dessaya/cese-tpfinal/Figures/disp-captura-cerrado.jpg

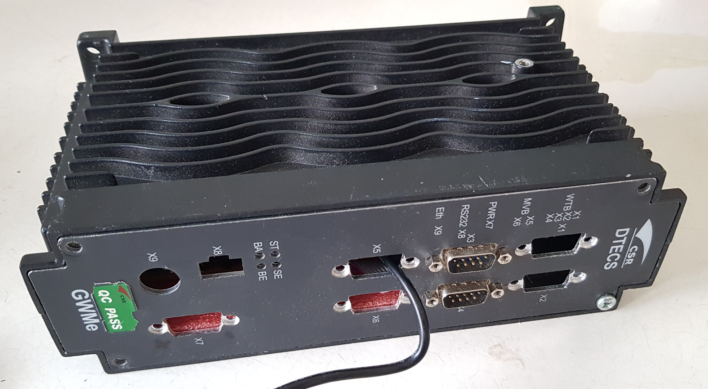
Figures/disp-captura-cerrado.jpg
