dessaya/cese-tpfinal/Figures/foto-dispositivo.jpg

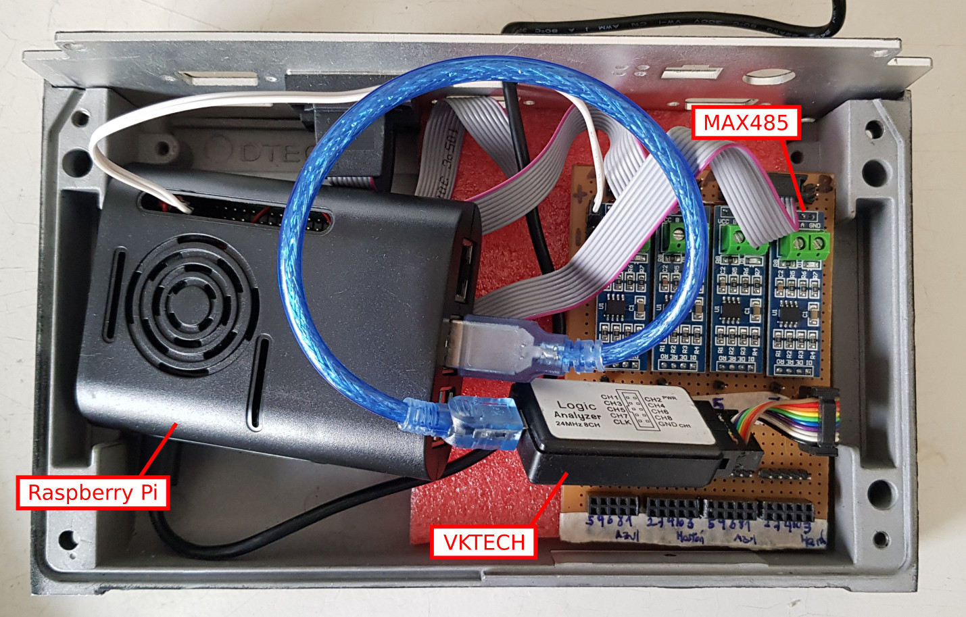
Figures/foto-dispositivo.jpg
