dessaya/cese-tpfinal/README.md

# Plantilla-CESE

Plantilla para la elaboración de la Memoria del Trabajo Final de la Carrera de Especialización en Sistemas Embebidos que se dicta en la Facultad de Ingeniería de la UBA.
