dessaya/cese-tpfinal/memoria.tex

% textwidth in cm: 13.69804cm

%%%%%%%%%%%%%%%%%%%%%%%%%%%%%%%%%%%%%%%%%%%%%%%%%%%%%%%%%%%%%%%%%%%%%%%%%%%%%%%%
%
% Template license:
% CC BY-NC-SA 3.0 (http://creativecommons.org/licenses/by-nc-sa/3.0/)
%
%%%%%%%%%%%%%%%%%%%%%%%%%%%%%%%%%%%%%%%%%%%%%%%%%%%%%%%%%%%%%%%%%%%%%%%%%%%%%%%%

% cant hojas: media = 30 a 40

%----------------------------------------------------------------------------------------
%	PACKAGES AND OTHER DOCUMENT CONFIGURATIONS
%----------------------------------------------------------------------------------------

\documentclass[
11pt, % The default document font size, options: 10pt, 11pt, 12pt
%oneside, % Two side (alternating margins) for binding by default, uncomment to switch to one side
%chapterinoneline,% Have the chapter title next to the number in one single line
spanish,
singlespacing, % Single line spacing, alternatives: onehalfspacing or doublespacing
%draft, % Uncomment to enable draft mode (no pictures, no links, overfull hboxes indicated)
%nolistspacing, % If the document is onehalfspacing or doublespacing, uncomment this to set spacing in lists to single
%liststotoc, % Uncomment to add the list of figures/tables/etc to the table of contents
%toctotoc, % Uncomment to add the main table of contents to the table of contents
parskip, % Uncomment to add space between paragraphs
%codirector, % Uncomment to add a codirector to the title page
headsepline, % Uncomment to get a line under the header
]{MastersDoctoralThesis} % The class file specifying the document structure

%----------------------------------------------------------------------------------------
%	INFORMACIÓN DE LA MEMORIA
%----------------------------------------------------------------------------------------

%    Dispositivo de captura para la red TCN en formaciones ferroviarias de Trenes Argentinos
%    Diseño y captura de la red TCN en formaciones ferroviarias de Trenes Argentinos
%    Desarrollo de dispositivo de captura para red TCN en formaciones ferroviarias de Trenes Argentinos
%    Dispositivo de captura de red TCN para formaciones ferroviarias de Trenes Argentinos
%    Implementación de dispositivo de captura para la red TCN en formaciones ferroviarias de Trenes Argentinos
\thesistitle{Dispositivo de captura para una red TCN}

% Nombre del posgrado, se usa en la carátula y se puede usar el cualquier lugar del documento con el comando \degreename
\posgrado{Carrera de Especialización en Sistemas Embebidos} 
%\posgrado{Carrera de Especialización en Internet de las Cosas} 
%\posgrado{Carrera de Especialización en Intelegencia Artificial}
%\posgrado{Maestría en Sistemas Embebidos} 
%\posgrado{Maestría en Internet de las cosas}

\author{Ing. Diego Essaya} % Tu nombre, se usa en la carátula y se puede usar el cualquier lugar del documento con el comando \authorname

\director{Dr. Ing. Pablo Martín Gomez (FIUBA)} % El nombre del director, se usa en la carátula y se puede usar el cualquier lugar del documento con el comando \dirname

\juradoUNO{Ing. Adrián Laiuppa (CONICET-GICSAFe)} % Nombre y pertenencia del un jurado se usa en la carátula y se puede usar el cualquier lugar del documento con el comando \jur1name
\juradoDOS{Mg. Ing. Sebastián Guarino (FIUBA)} % Nombre y pertenencia del un jurado se usa en la carátula y se puede usar el cualquier lugar del documento con el comando \jur2name
\juradoTRES{Mg. Ing. Martín Menéndez (FIUBA)} % Nombre y pertenencia del un jurado se usa en la carátula y se puede usar el cualquier lugar del documento con el comando \jur3name

\ciudad{Ciudad Autónoma de Buenos Aires}

\fechaINICIO{septiembre de 2019}
\fechaFINAL{marzo de 2023}

\keywords{Sistemas embebidos, FIUBA} % Keywords for your thesis, print it elsewhere with \keywordnames

\newcommand\todo[1]{\textcolor{red}{#1}}

\usepackage[T1]{fontenc}
\usepackage{inconsolata}

\lstset{
  basicstyle=\small\ttfamily,
  breaklines=true,
}

\begin{document}

\definecolor{light-gray}{gray}{0.95}

\frontmatter % Use roman page numbering style (i, ii, iii, iv...) for the pre-content pages

\pagestyle{plain} % Default to the plain heading style until the thesis style is called for the body content

%----------------------------------------------------------------------------------------
%	RESUMEN - ABSTRACT 
%----------------------------------------------------------------------------------------

\begin{abstract}
\addchaptertocentry{\abstractname} % Add the abstract to the table of contents
%
%The Thesis Abstract is written here (and usually kept to just this page). The page is kept centered vertically so can expand into the blank space above the title too\ldots
\centering

La presente memoria describe el diseño y desarrollo de un dispositivo que permite capturar la información que circula por la red interna de una formación ferroviaria. Este trabajo fue desarrollado como parte de la convocatoria de Proyectos de Desarrollo Estratégico 2020 de UBACyT, con Trenes Argentinos como entidad adoptante.

El dispositivo desarrollado permite que Trenes Argentinos pueda monitorear los diferentes subsistemas presentes en una formación ferroviaria, ya sea para visualizar su estado en tiempo real o para archivar. Esto cubre la falta de tecnología propia para operar y mantener las formaciones, ya que históricamente hubo que recurrir a empresas extranjeras que ofrecen productos cerrados y de difícil acceso. En el trabajo se aplicaron conocimientos de protocolos de comunicación, programación de microprocesadores y programación de alto nivel.

\end{abstract}

%----------------------------------------------------------------------------------------
%	CONTENIDO DE LA MEMORIA  - AGRADECIMIENTOS
%----------------------------------------------------------------------------------------

\begin{acknowledgements}
\addchaptertocentry{\acknowledgementname}
\vspace{1.5cm}

A Pablo Gomez por su invaluable ayuda en la elaboración de este trabajo.

A los organizadores de la Carrera de Especialización en Sistemas Embebidos por otorgarme una beca, y brindarme la oportunidad de participar en el GICSAFe.

Al personal de los talleres Victoria y Castelar de Trenes Argentinos por su colaboración y paciencia en la realización de las mediciones, en particular a Sergio Dieleke y Bruno Pilato.

\end{acknowledgements}

%----------------------------------------------------------------------------------------
%	LISTA DE CONTENIDOS/FIGURAS/TABLAS
%----------------------------------------------------------------------------------------

\tableofcontents % Prints the main table of contents

\listoffigures % Prints the list of figures

% \listoftables % Prints the list of tables

%----------------------------------------------------------------------------------------
%	CONTENIDO DE LA MEMORIA  - CAPÍTULOS
%----------------------------------------------------------------------------------------

\mainmatter % Begin numeric (1,2,3...) page numbering

\pagestyle{thesis} % Return the page headers back to the "thesis" style

% Incluir los capítulos como archivos separados desde la carpeta Chapters

\include{Chapters/Chapter1}
\include{Chapters/Chapter2} 
\include{Chapters/Chapter3}
\include{Chapters/Chapter4} 
\include{Chapters/Chapter5} 

%----------------------------------------------------------------------------------------
%	CONTENIDO DE LA MEMORIA  - APÉNDICES
%----------------------------------------------------------------------------------------

\appendix % indicativo para indicarle a LaTeX los siguientes "capítulos" son apéndices

% Incluir los apéndices de la memoria como archivos separadas desde la carpeta Appendices
% Descomentar las líneas a medida que se escriben los apéndices

%\include{Appendices/AppendixA}
%\include{Appendices/AppendixB}
%\include{Appendices/AppendixC}

%----------------------------------------------------------------------------------------
%	BIBLIOGRAPHY
%----------------------------------------------------------------------------------------

\Urlmuskip=0mu plus 1mu\relax
\raggedright
\printbibliography[heading=bibintoc]

%----------------------------------------------------------------------------------------

\end{document}
