dessaya/cese-tpfinal/Figures/RCMe.pdf

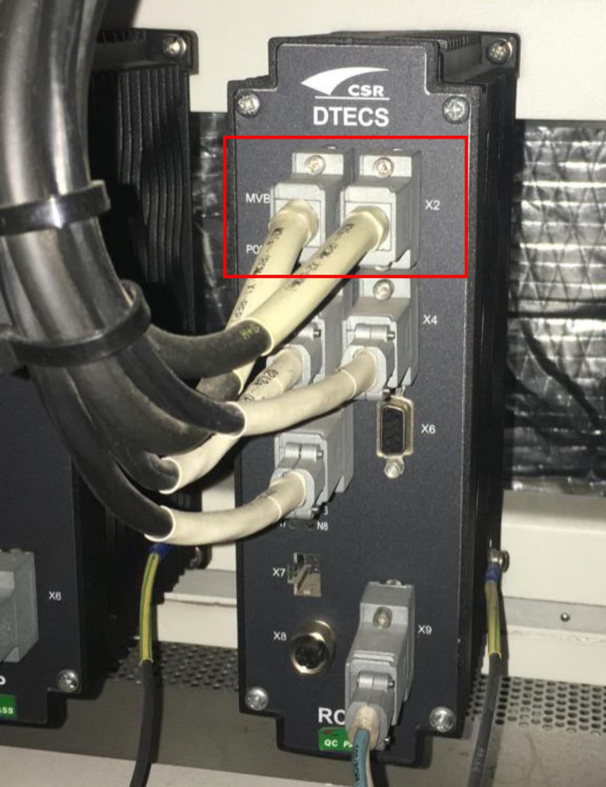
[picture p3: page 1]
