dessaya/cese-tpfinal/Figures/1082px-Línea_Mitre_Retiro.jpg

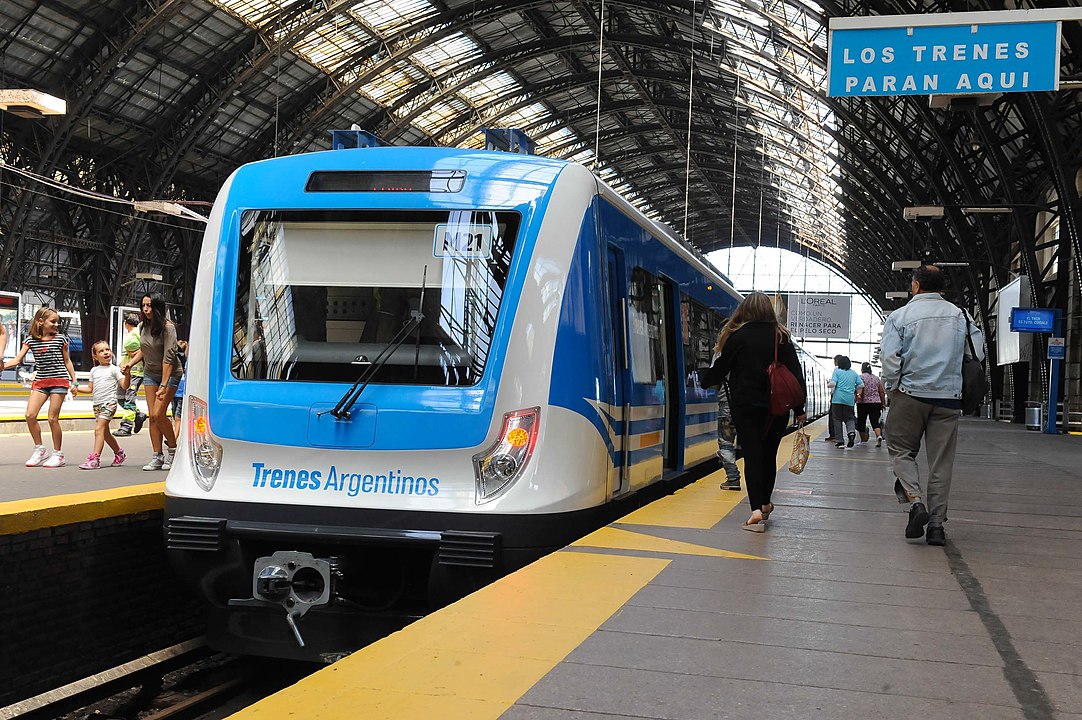
Figures/1082px-Línea_Mitre_Retiro.jpg
