dessaya/cese-tpfinal/Figures/amit.jpg

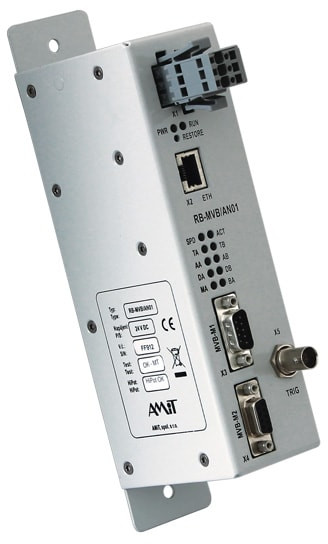
Figures/amit.jpg
