dessaya/cese-tpfinal/Figures/analisis-captura.png

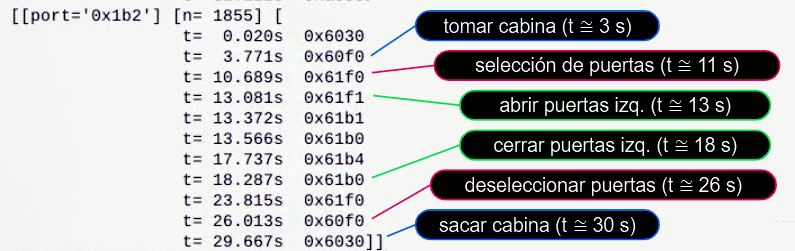
Figures/analisis-captura.png
