dessaya/cese-tpfinal/Figures/clon-saleae.jpg

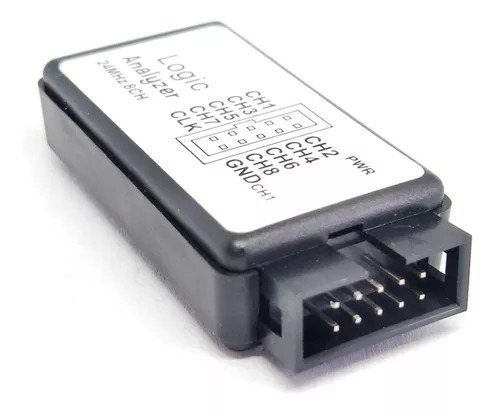
Figures/clon-saleae.jpg
