dessaya/cese-tpfinal/Figures/disp-captura-ssh.jpg

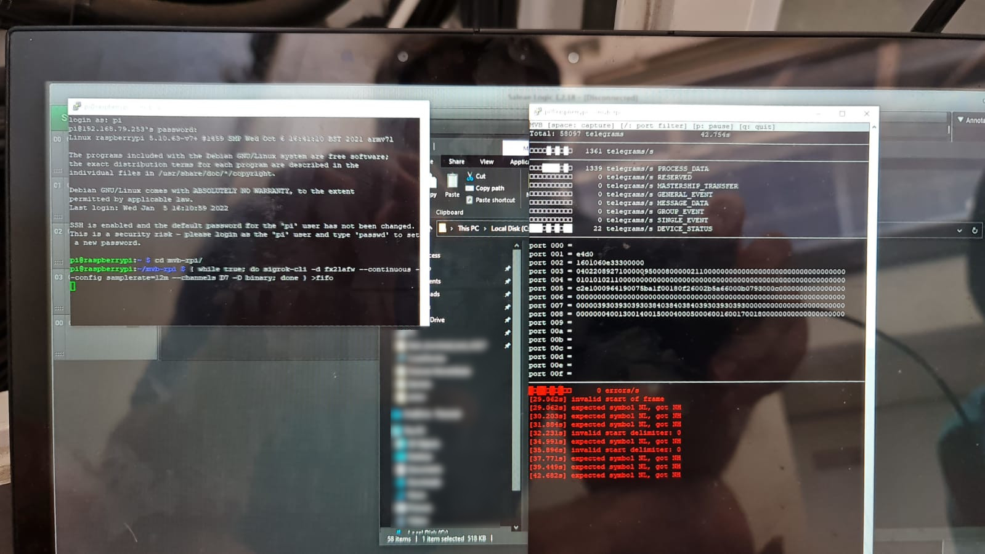
Figures/disp-captura-ssh.jpg
