dessaya/cese-tpfinal/Figures/duagon.png

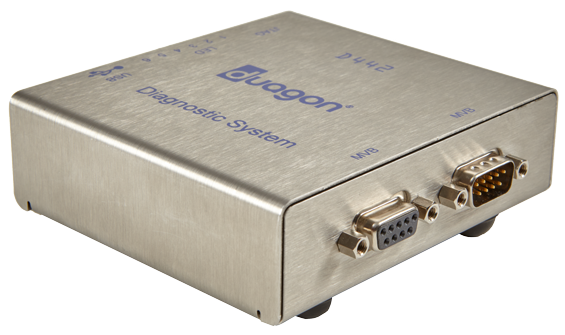
Figures/duagon.png
