dessaya/cese-tpfinal/Figures/educiaa+vktech.jpg

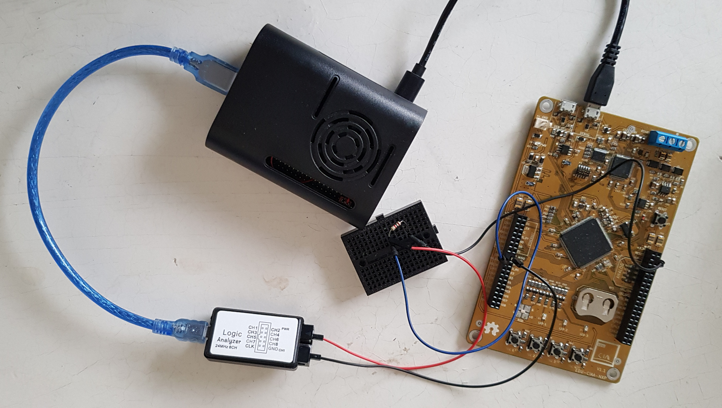
Figures/educiaa+vktech.jpg
