dessaya/cese-tpfinal/Figures/esquematico.png

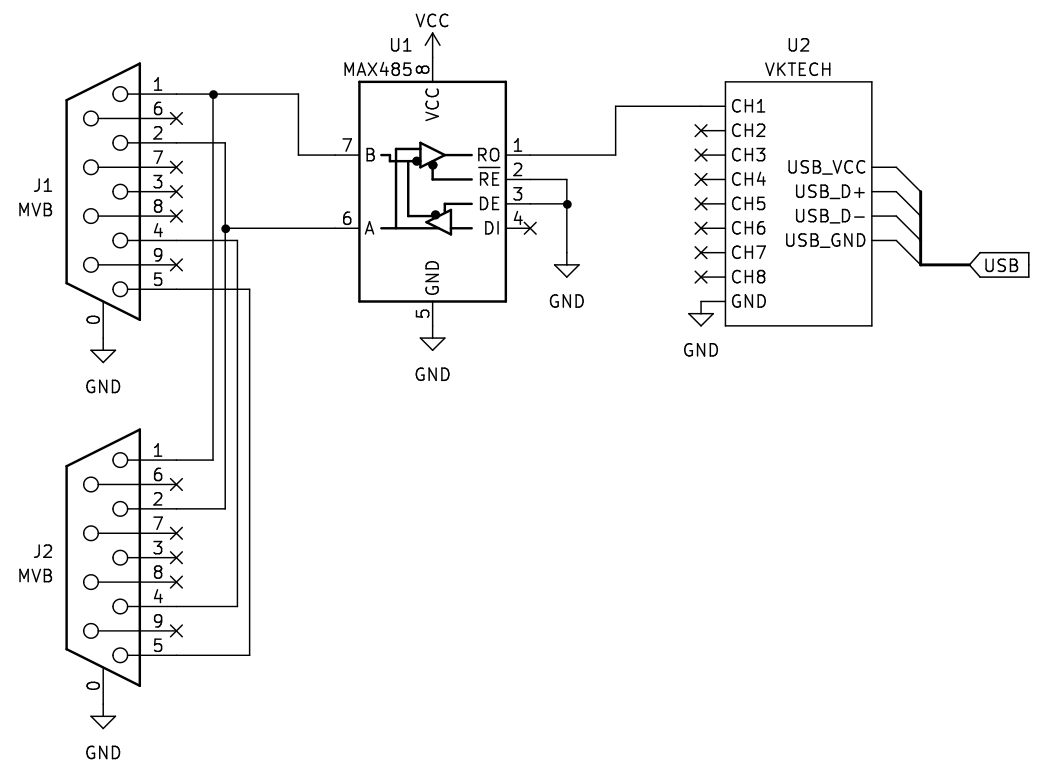
Figures/esquematico.png
