dessaya/cese-tpfinal/Figures/foto-capturas.jpg

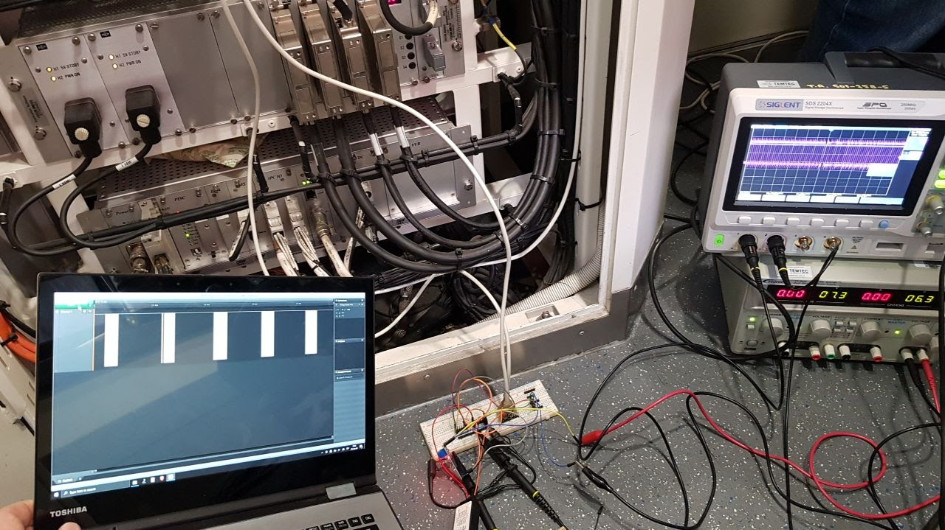
Figures/foto-capturas.jpg
