dessaya/cese-tpfinal/Figures/hmi.jpg

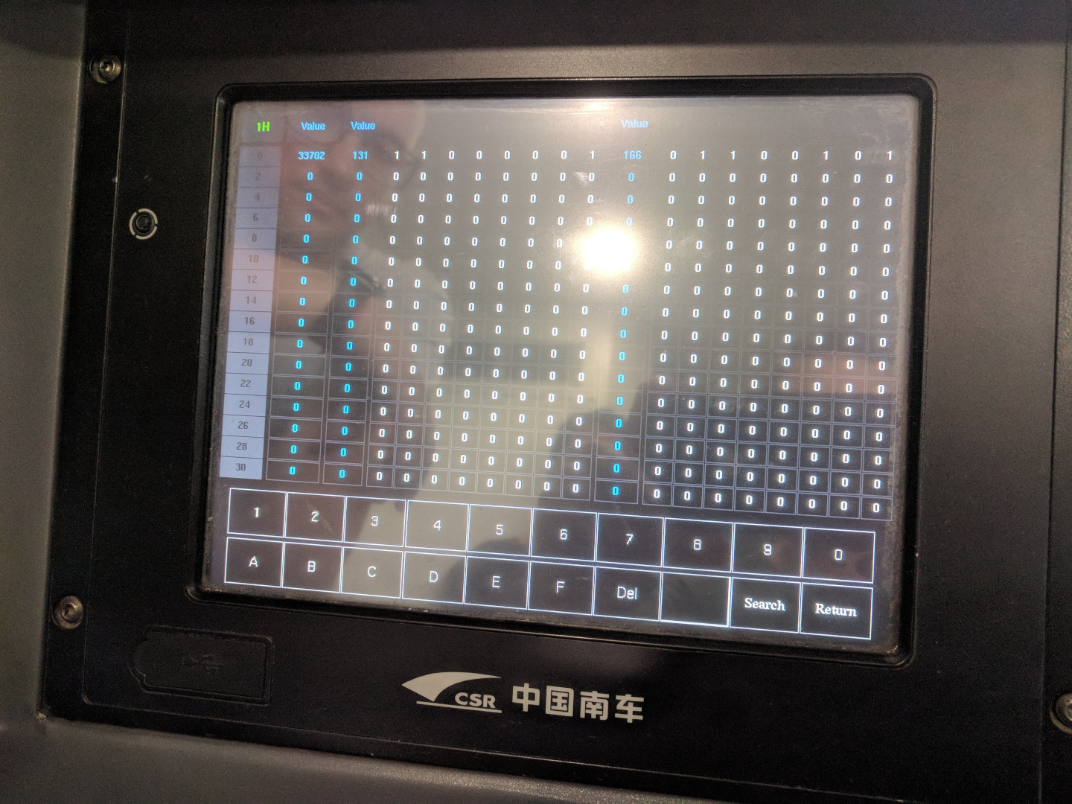
Figures/hmi.jpg
