dessaya/cese-tpfinal/Figures/osciloscopio.jpg

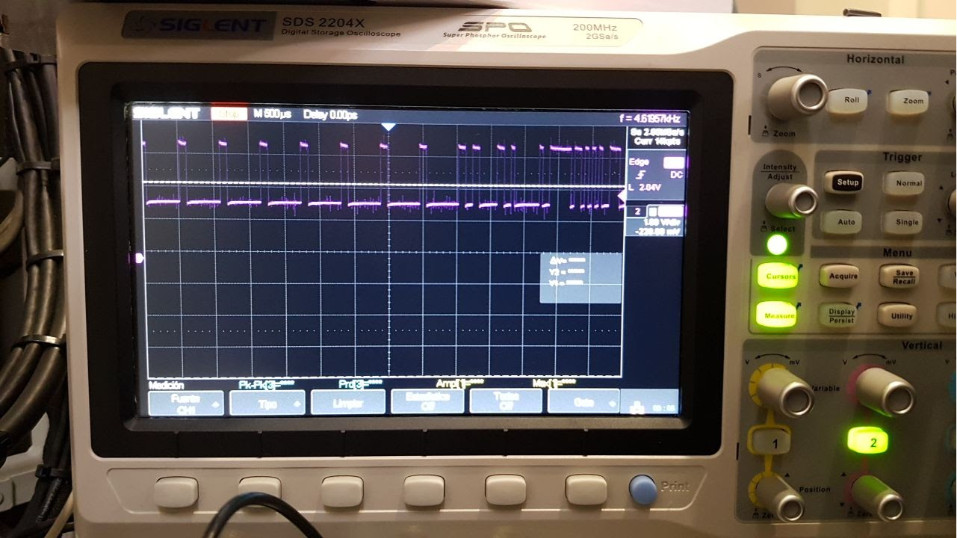
Figures/osciloscopio.jpg
