dessaya/cese-tpfinal/Figures/pulseview.png

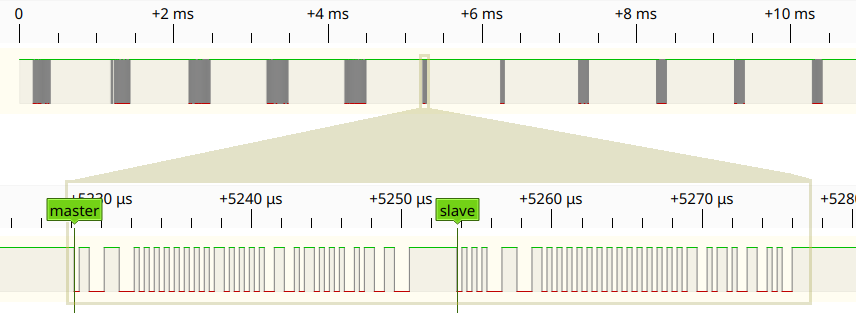
Figures/pulseview.png
