dessaya/cese-tpfinal/Figures/yacer.jpg

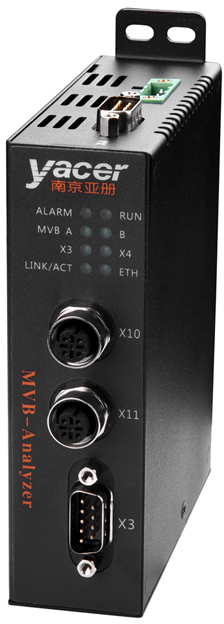
Figures/yacer.jpg
