dessaya/cese-tpfinal/Figures/modo-interactivo.pdf

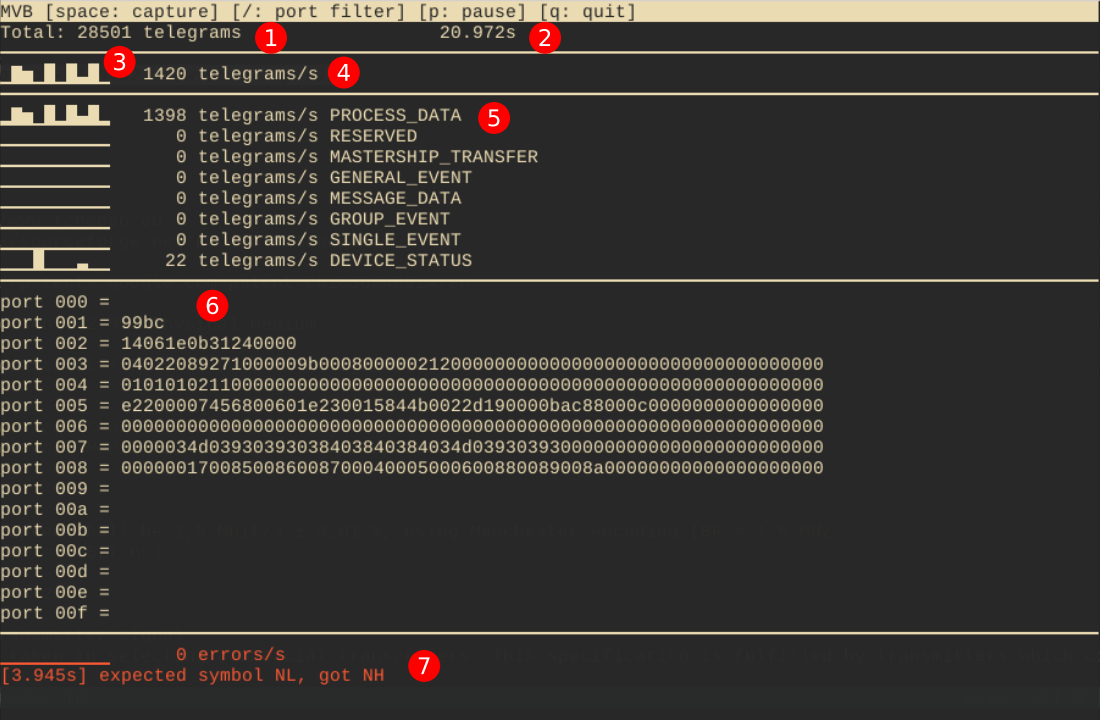
[picture p17: page 1]
