dessaya/cese-tpfinal/kicad/mvb/mvb.kicad_pcb

## KiCad design MCY7880_computer/CPU_sch.kicad_sch

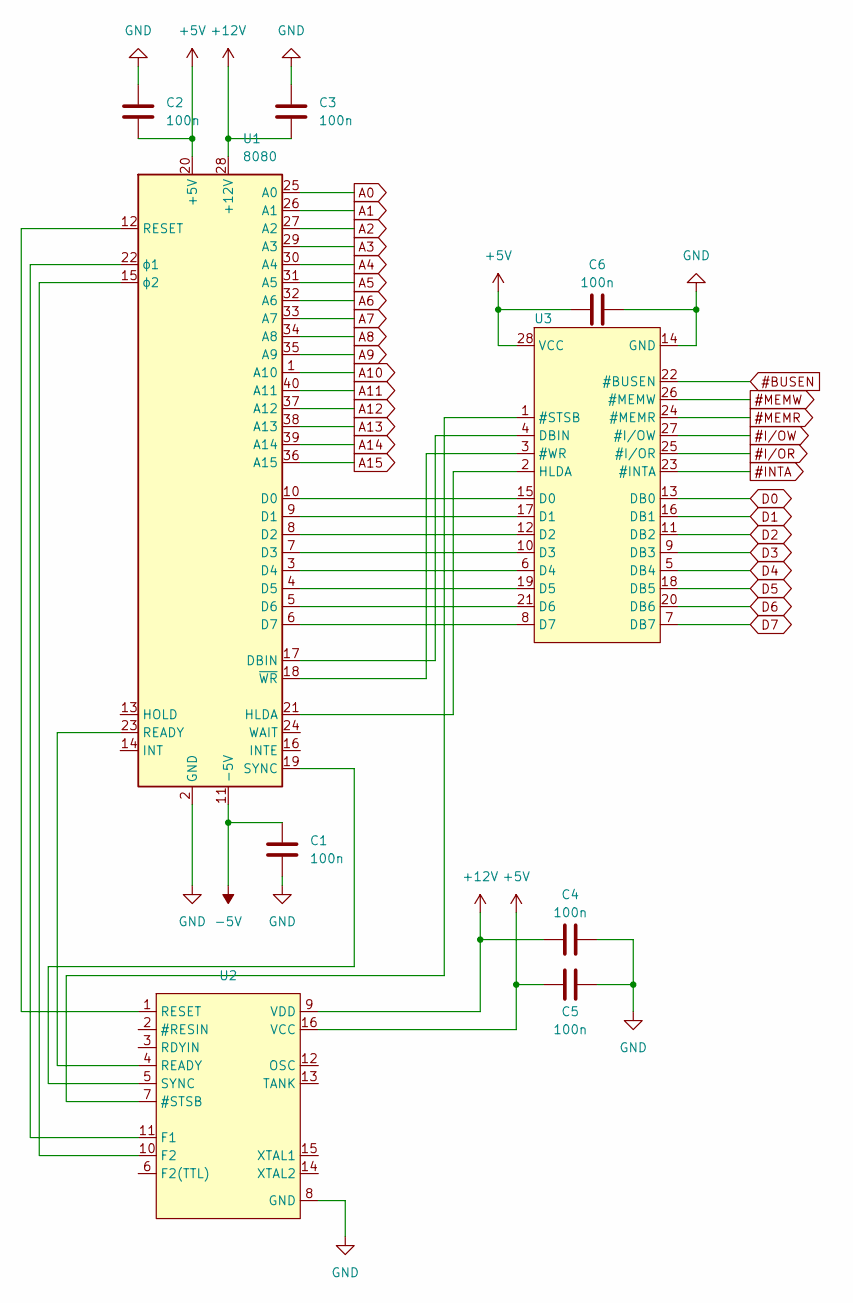
[picture p18: schematic CPU_sch.kicad_sch]

Parts:
C1, C2, C3, C4, C5, C6: 100n
U1: 8080; DIP-40_W15.24mm
U2: DIP-16_W7.62mm_LongPads
U3: DIP-28_W15.24mm_LongPads

Connections:
#BUSEN: U3.22 (#BUSEN)
#INTA: U3.23 (#INTA)
#I/OR: U3.25 (#I/OR)
#I/OW: U3.27 (#I/OW)
#MEMR: U3.24 (#MEMR)
#MEMW: U3.26 (#MEMW)
+5V: C2.2, C5.2, C6.1, U1.20 (+5V), U2.16 (VCC), U3.28 (VCC)
+12V: C3.2, C4.1, U1.28 (+12V), U2.9 (VDD)
-5V: C1.1, U1.11 (-5V)
A0: U1.25 (A0)
A1: U1.26 (A1)
A2: U1.27 (A2)
A3: U1.29 (A3)
A4: U1.30 (A4)
A5: U1.31 (A5)
A6: U1.32 (A6)
A7: U1.33 (A7)
A8: U1.34 (A8)
A9: U1.35 (A9)
A10: U1.1 (A10)
A11: U1.40 (A11)
A12: U1.37 (A12)
A13: U1.38 (A13)
A14: U1.39 (A14)
A15: U1.36 (A15)
D0: U3.13 (DB0)
D1: U3.16 (DB1)
D2: U3.11 (DB2)
D3: U3.9 (DB3)
D4: U3.5 (DB4)
D5: U3.18 (DB5)
D6: U3.20 (DB6)
D7: U3.7 (DB7)
GND: C1.2, C2.1, C3.1, C4.2, C5.1, C6.2, U1.2 (GND), U2.8 (GND), U3.14 (GND)
unnamed: U1.3 (D4), U3.6 (D4)
unnamed: U1.4 (D5), U3.19 (D5)
unnamed: U1.5 (D6), U3.21 (D6)
unnamed: U1.6 (D7), U3.8 (D7)
unnamed: U1.7 (D3), U3.10 (D3)
unnamed: U1.8 (D2), U3.12 (D2)
unnamed: U1.9 (D1), U3.17 (D1)
unnamed: U1.10 (D0), U3.15 (D0)
unnamed: U1.12 (RESET), U2.1 (RESET)
unnamed: U1.15 (ϕ2), U2.10 (F2)
unnamed: U1.17 (DBIN), U3.4 (DBIN)
unnamed: U1.18 (~WR), U3.3 (#WR)
unnamed: U1.19 (SYNC), U2.5 (SYNC)
unnamed: U1.21 (HLDA), U3.2 (HLDA)
unnamed: U1.22 (ϕ1), U2.11 (F1)
unnamed: U1.23 (READY), U2.4 (READY)
unnamed: U2.7 (#STSB), U3.1 (#STSB)
